Crafty-The-Fox/musec_pico_rp2040/PCB/pico/musec_pico.kicad_sch

## KiCad design PCB/pico/musec_pico.kicad_sch (2025-07-09)

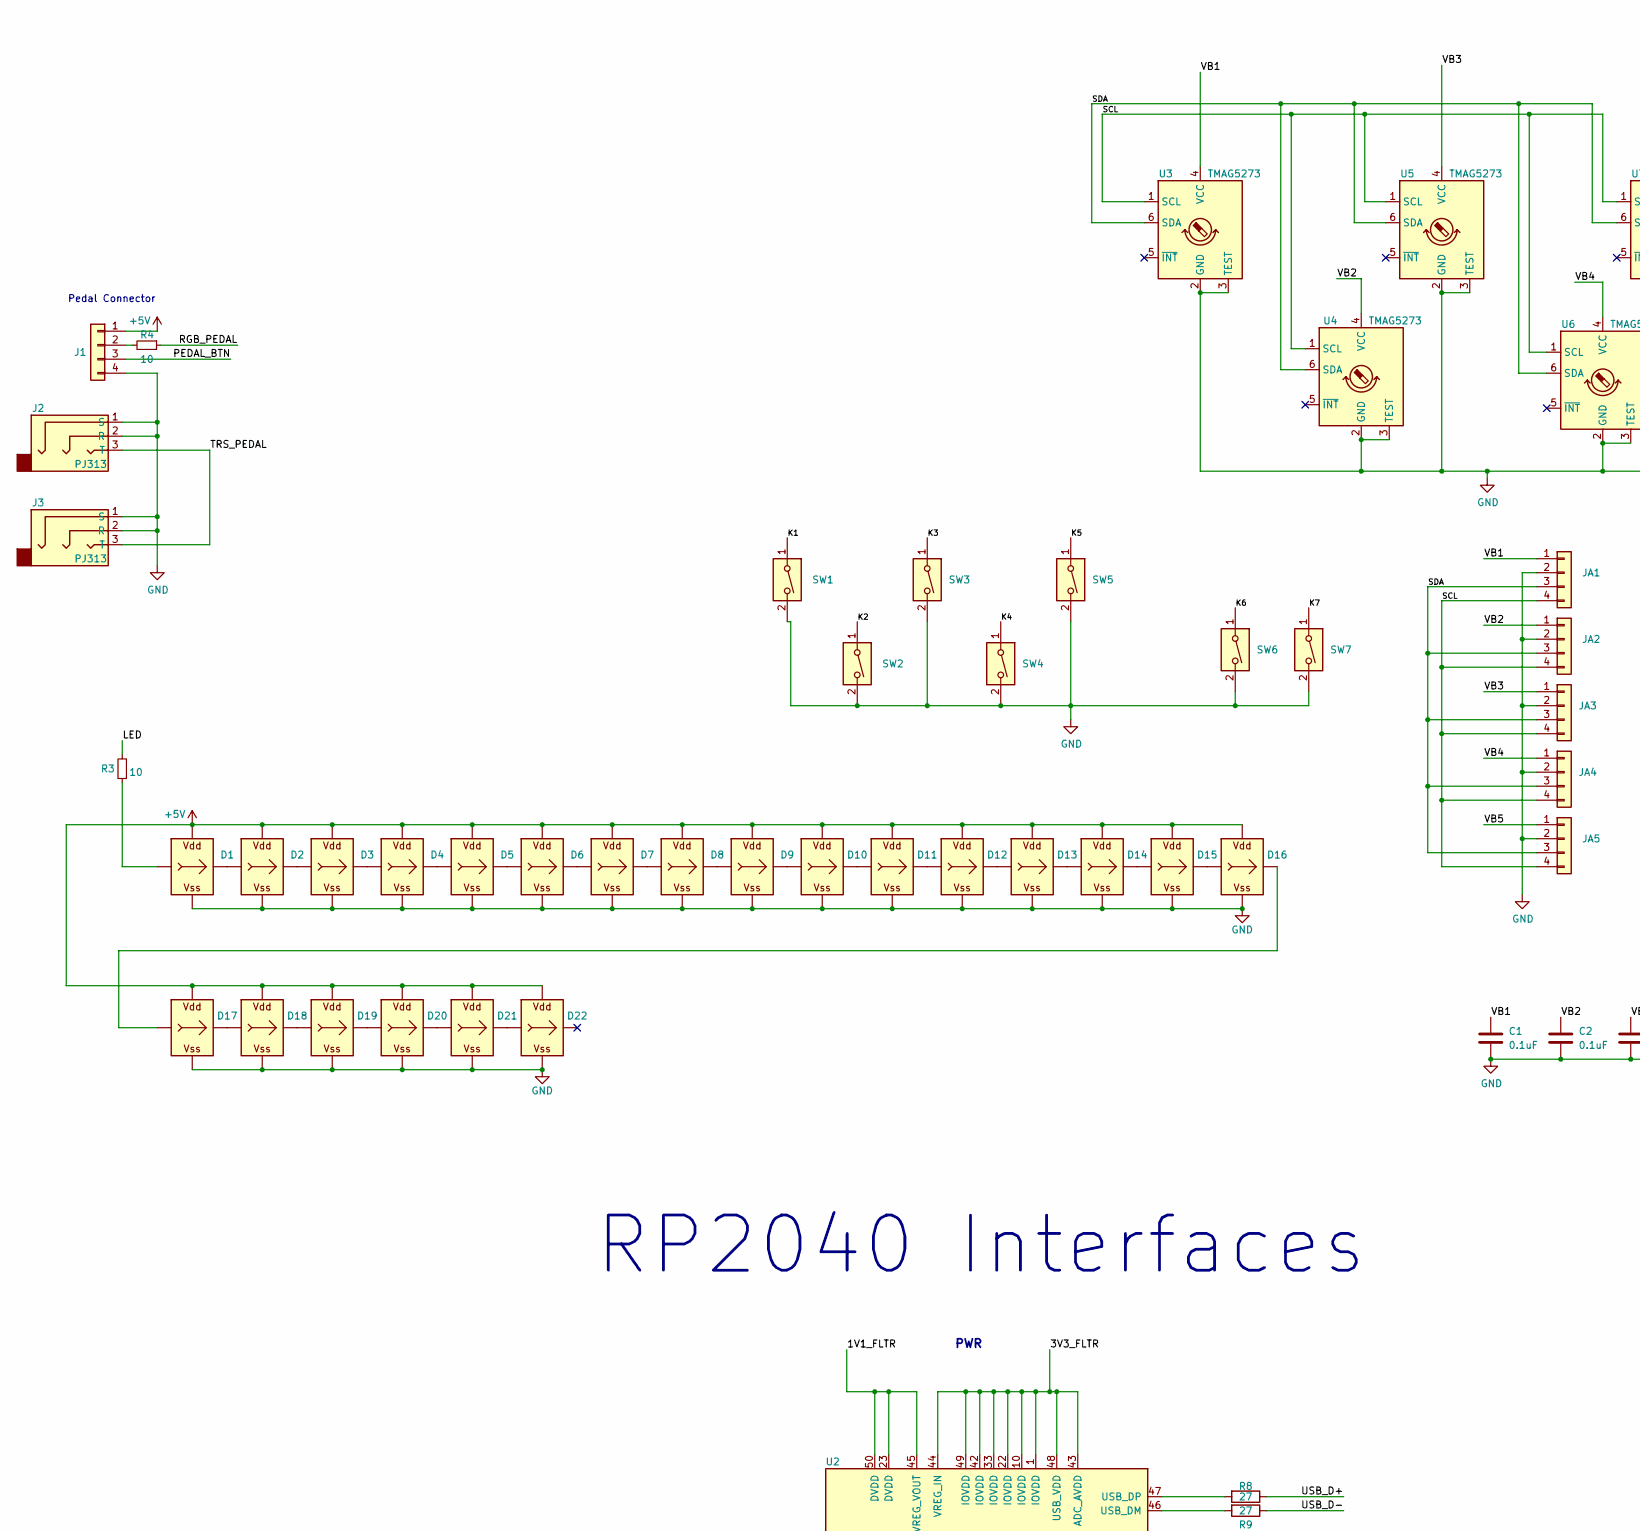
[picture p1: schematic musec_pico.kicad_sch, part in row 1, column 1]

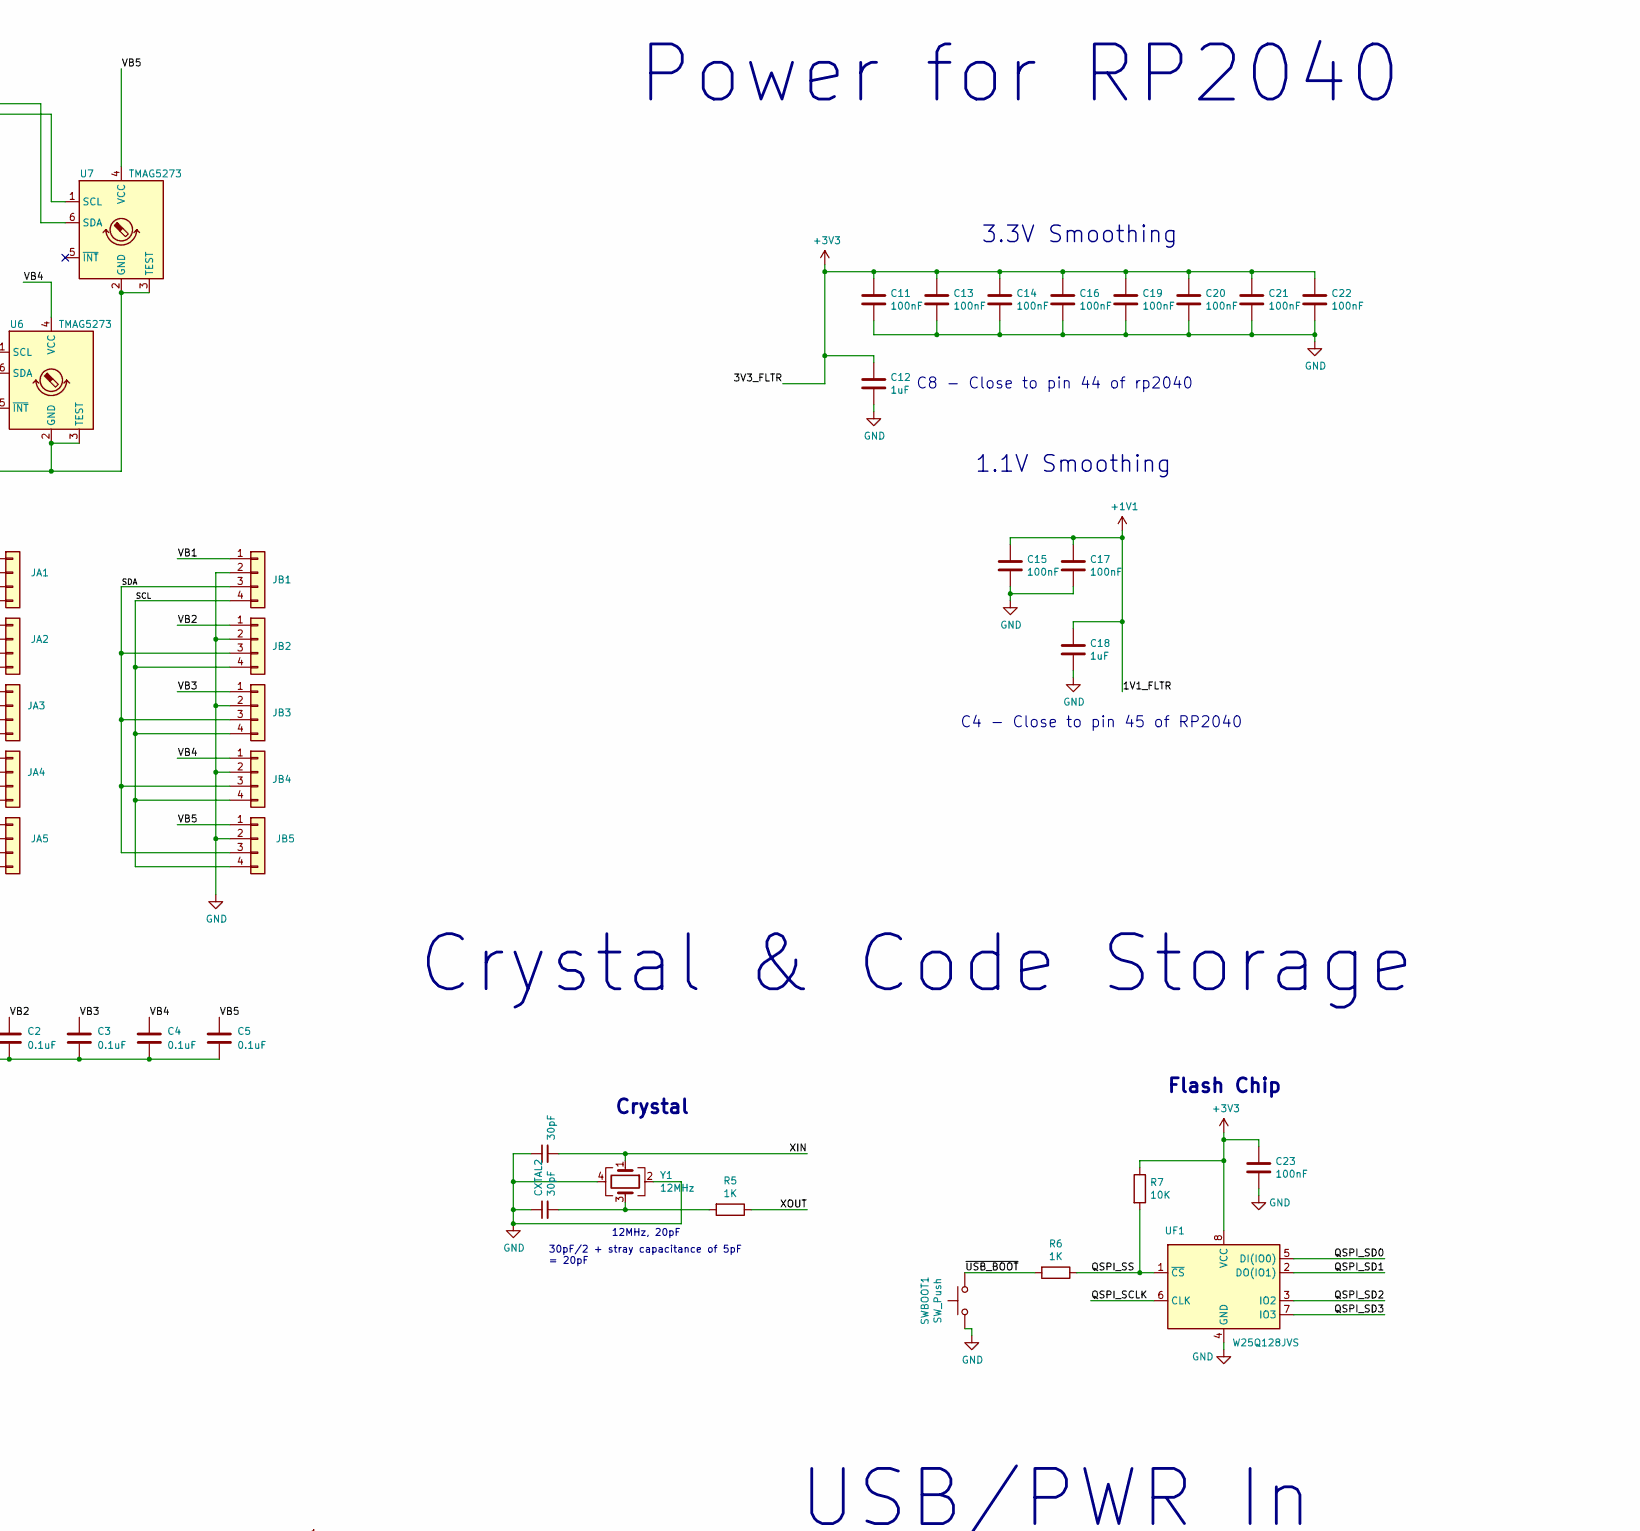
[picture p2: schematic musec_pico.kicad_sch, part in row 1, column 2]

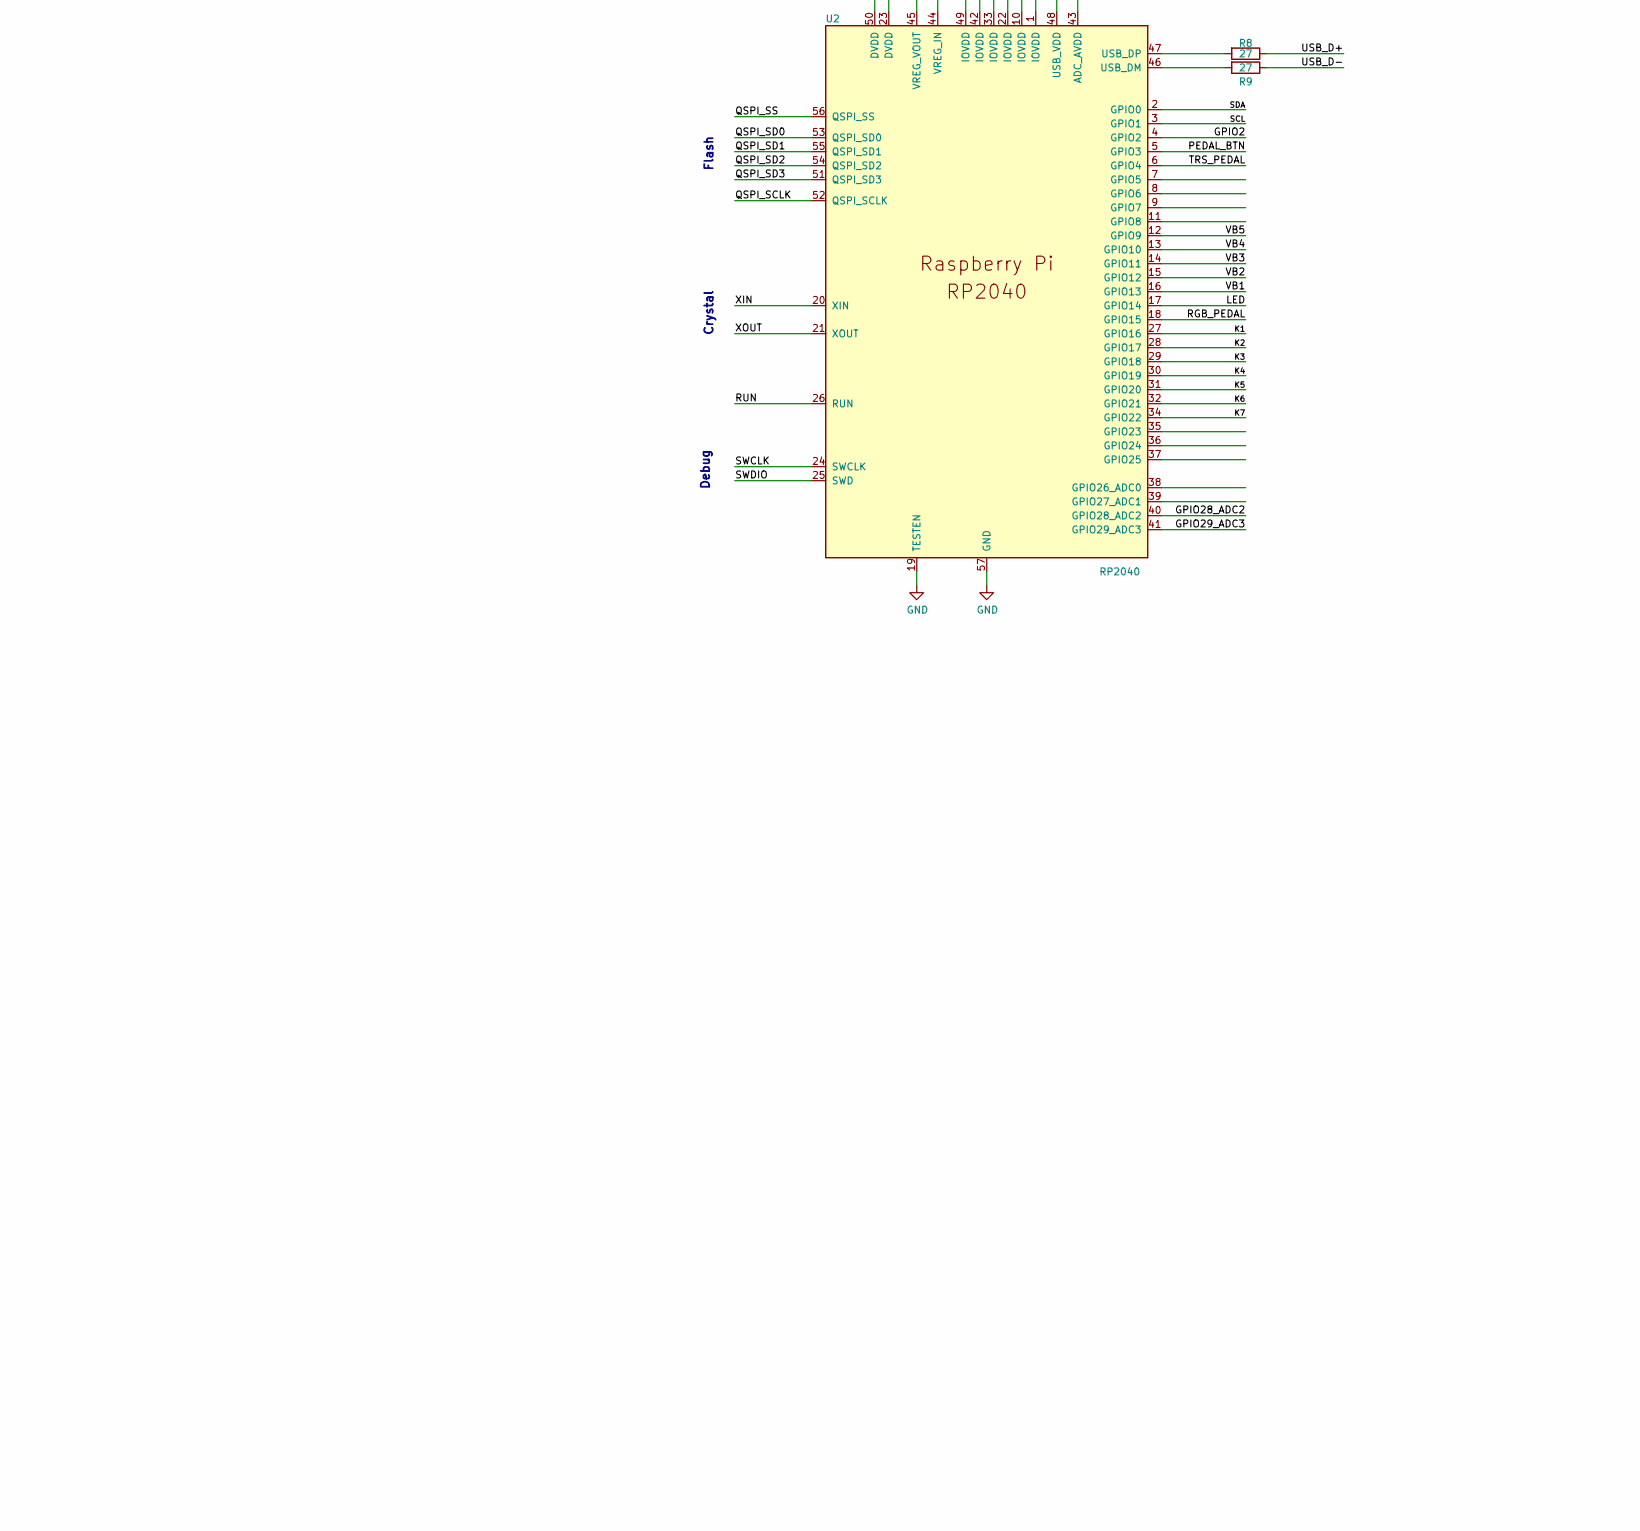
[picture p3: schematic musec_pico.kicad_sch, part in row 2, column 1]

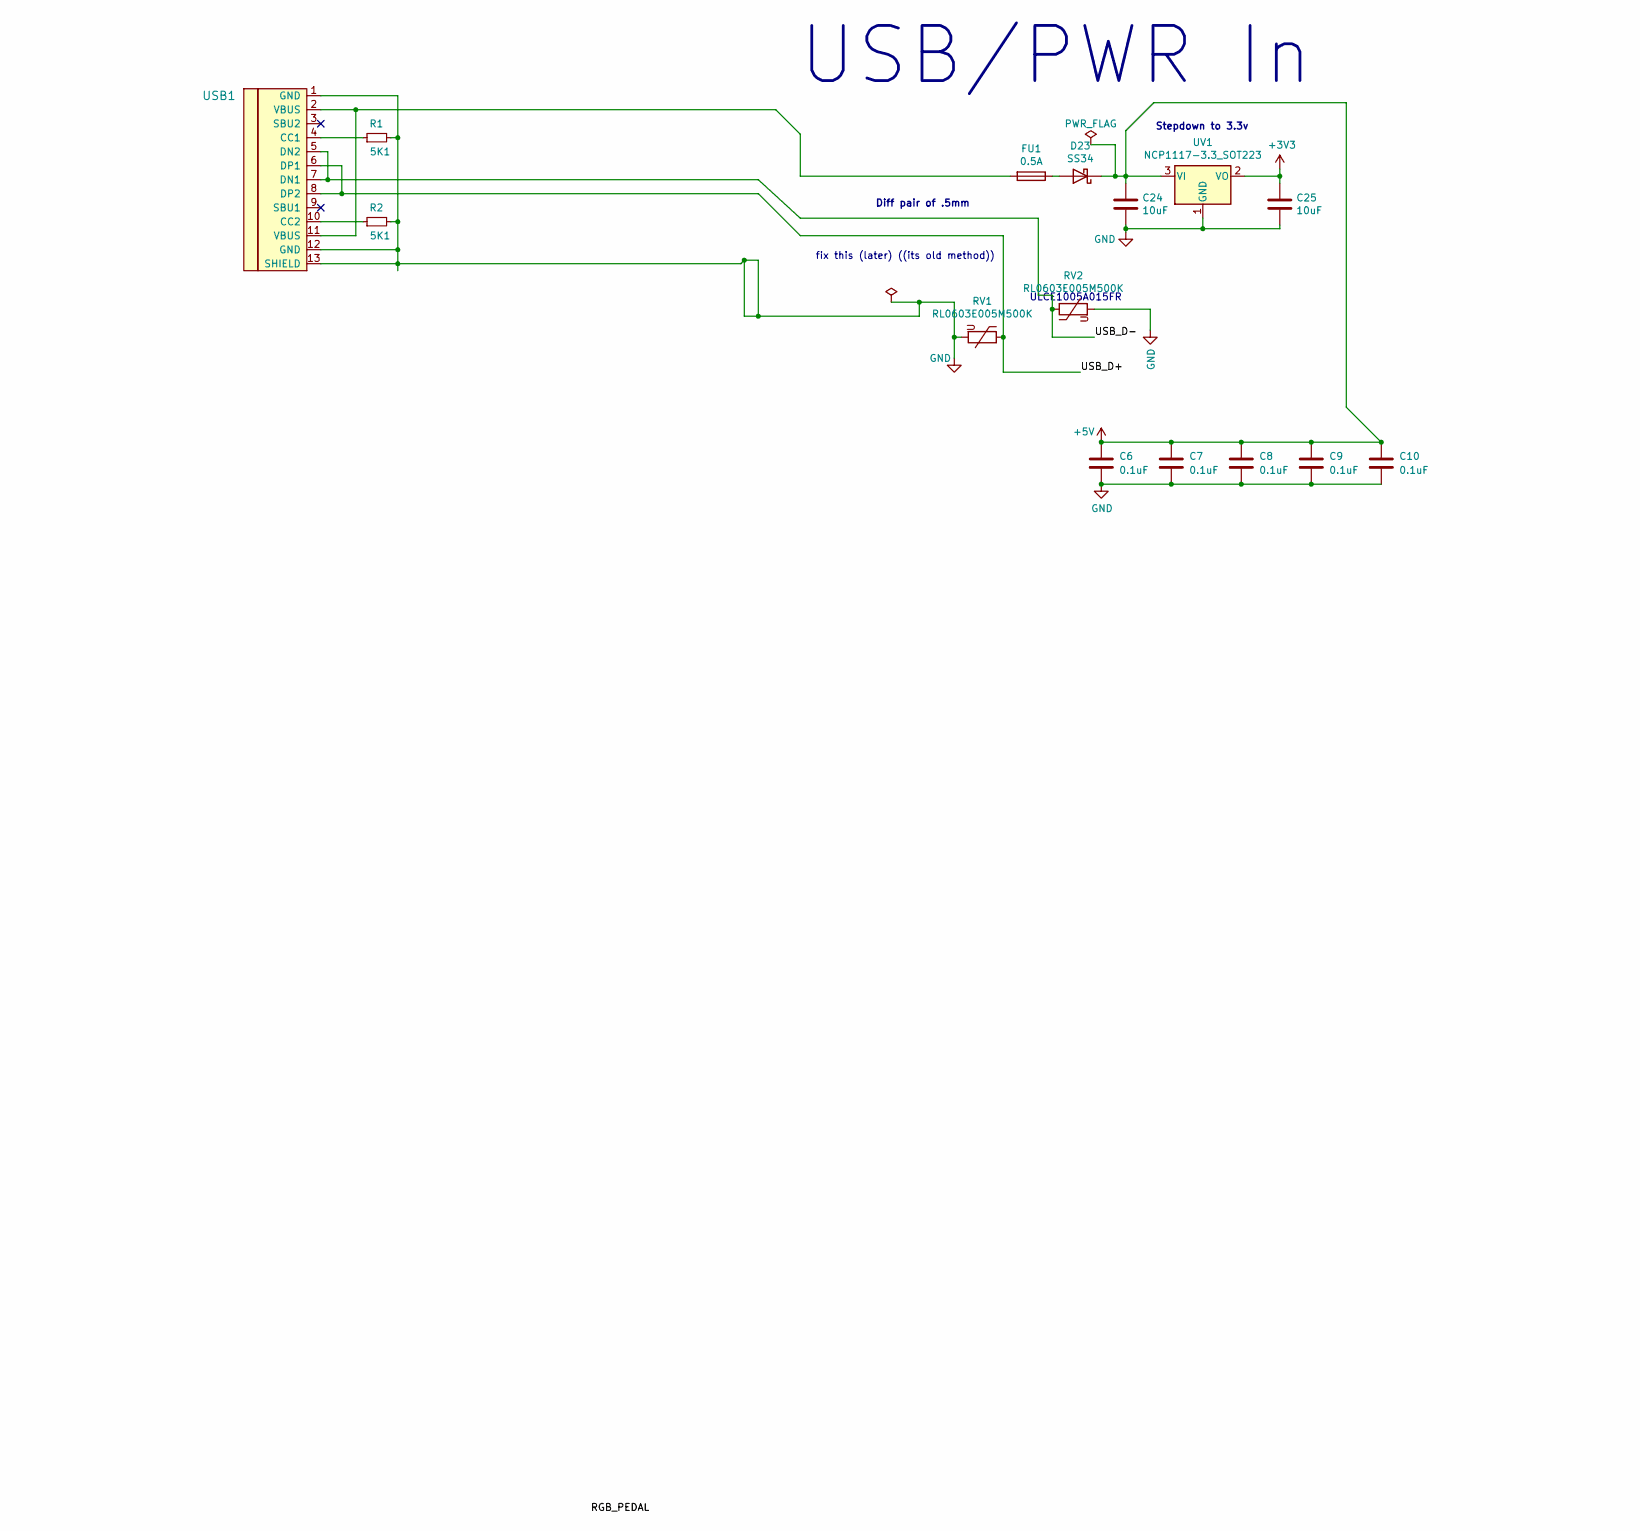
[picture p4: schematic musec_pico.kicad_sch, part in row 2, column 2]

Parts:
C1, C2, C3, C4, C5, C6, C7, C8, C9, C10: 0.1uF; C_0603_1608Metric_Pad1.08x0.95mm_HandSolder
C11, C13, C14, C15, C16, C17, C19, C20, C21, C22, C23: 100nF; C_0402_1005Metric; LCSC C1525
C12, C18: 1uF; C_0402_1005Metric; LCSC C52923
C24, C25: 10uF; C_0805_2012Metric; LCSC C15850
CXTAL1, CXTAL2: 30pF; C_0402_1005Metric; LCSC C1570
D1, D2, D3, D4, D5, D6, D7, D8, D9, D10, D11, D12, D13, D14, D15, D16, D17, D18, D19, D20, D21, D22: WS2812B_Unified; WS2812B-2835
D23: SS34; D_SMA; LCSC C8678
FU1: 0.5A; Fuse_1206_3216Metric_Pad1.42x1.75mm_HandSolder; LCSC C70068
J1: Pedal; SH1.0_4P_Solder_Combo
J2, J3: PJ313
JA1, JA2, JA3, JA4, JA5: Conn_01x04; SH1.0_4P_Solder_Combo
JB1, JB2, JB3, JB4, JB5: Conn_01x04; SH1.0_4P_Solder_Combo
R1, R2: 5K1; R_0603_1608Metric_Pad0.98x0.95mm_HandSolder; LCSC C23186
R3, R4: 10; R_0603_1608Metric_Pad0.98x0.95mm_HandSolder; LCSC C23186
R5: 1K; R_0402_1005Metric; LCSC C11702
R6: 1K; R_0603_1608Metric_Pad0.98x0.95mm_HandSolder; LCSC C21190
R7: 10K; R_0603_1608Metric_Pad0.98x0.95mm_HandSolder; LCSC C25804
R8, R9: 27; R_0603_1608Metric_Pad0.98x0.95mm_HandSolder; LCSC C25190
RV1, RV2: RL0603E005M500K; R_0603_1608Metric_Pad0.98x0.95mm_HandSolder; LCSC C20960
SW1, SW2, SW3, SW4, SW5, SW6, SW7: SW_DIP_x01; SW_Kailh_Choc_V1V2_1.00u_LED
SWBOOT1: SW_Push; SW_PUSH_6mm_H4.3mm
U2: RP2040; RP2040-QFN-56; LCSC C2040
U3, U4, U5, U6, U7: TMAG5273; TSOT-23-6_HandSoldering
UF1: W25Q128JVS; SOIC-8_5.275x5.275mm_P1.27mm; LCSC C97521
USB1: U262-161N-4BVC11; HRO-TYPE-C-31-M-12-Assembly; LCSC C319148
UV1: NCP1117-3.3_SOT223; SOT-223-3_TabPin2; LCSC C146799
Y1: 12MHz; Crystal_SMD_3225-4Pin_3.2x2.5mm; LCSC C9002

Connections:
+1V1: C15.1, C17.1, C18.1, U2.23 (DVDD), U2.45 (VREG_VOUT), U2.50 (DVDD)
+3V3: C11.1, C12.1, C13.1, C14.1, C16.1, C19.1, C20.1, C21.1, C22.1, C23.1, C25.1, R7.1, U2.1 (IOVDD), U2.10 (IOVDD), U2.22 (IOVDD), U2.33 (IOVDD), U2.42 (IOVDD), U2.43 (ADC_AVDD), U2.44 (VREG_IN), U2.48 (USB_VDD), U2.49 (IOVDD), UF1.8 (VCC), UV1.2 (VO)
+5V: C6.1, C7.1, C8.1, C9.1, C10.1, C24.1, D1.V (VDD), D2.V (VDD), D3.V (VDD), D4.V (VDD), D5.V (VDD), D6.V (VDD), D7.V (VDD), D8.V (VDD), D9.V (VDD), D10.V (VDD), D11.V (VDD), D12.V (VDD), D13.V (VDD), D14.V (VDD), D15.V (VDD), D16.V (VDD), D17.V (VDD), D18.V (VDD), D19.V (VDD), D20.V (VDD), D21.V (VDD), D22.V (VDD), D23.1 (K), J1.1, UV1.3 (VI)
GND: C1.2, C2.2, C3.2, C4.2, C5.2, C6.2, C7.2, C8.2, C9.2, C10.2, C11.2, C12.2, C13.2, C14.2, C15.2, C16.2, C17.2, C18.2, C19.2, C20.2, C21.2, C22.2, C23.2, C24.2, C25.2, CXTAL1.1, CXTAL2.1, D1.G (VSS), D2.G (VSS), D3.G (VSS), D4.G (VSS), D5.G (VSS), D6.G (VSS), D7.G (VSS), D8.G (VSS), D9.G (VSS), D10.G (VSS), D11.G (VSS), D12.G (VSS), D13.G (VSS), D14.G (VSS), D15.G (VSS), D16.G (VSS), D17.G (VSS), D18.G (VSS), D19.G (VSS), D20.G (VSS), D21.G (VSS), D22.G (VSS), J1.4, J2.1 (S), J2.2 (R), J3.1 (S), J3.2 (R), JA1.2, JA2.2, JA3.2, JA4.2, JA5.2, JB1.2, JB2.2, JB3.2, JB4.2, JB5.2, R1.2, R2.2, RV1.2, RV2.2, SW1.2, SW2.2, SW3.2, SW4.2, SW5.2, SW6.2, SW7.2, SWBOOT1.1, U2.19 (TESTEN), U2.57 (GND), U3.2 (GND), U3.3 (TEST), U4.2 (GND), U4.3 (TEST), U5.2 (GND), U5.3 (TEST), U6.2 (GND), U6.3 (TEST), U7.2 (GND), U7.3 (TEST), UF1.4 (GND), USB1.1 (GND), USB1.12 (GND), USB1.13 (SHIELD), UV1.1 (GND), Y1.2, Y1.4
GPIO2: U2.4 (GPIO2)
GPIO28_ADC2: U2.40 (GPIO28_ADC2)
GPIO29_ADC3: U2.41 (GPIO29_ADC3)
K1: SW1.1, U2.27 (GPIO16)
K2: SW2.1, U2.28 (GPIO17)
K3: SW3.1, U2.29 (GPIO18)
K4: SW4.1, U2.30 (GPIO19)
K5: SW5.1, U2.31 (GPIO20)
K6: SW6.1, U2.32 (GPIO21)
K7: SW7.1, U2.34 (GPIO22)
LED: R3.2, U2.17 (GPIO14)
unnamed: CXTAL2.2, R5.2, Y1.3
unnamed: D1.I (In), R3.1
unnamed: D1.O (Out), D2.I (In)
unnamed: D2.O (Out), D3.I (In)
unnamed: D3.O (Out), D4.I (In)
unnamed: D4.O (Out), D5.I (In)
unnamed: D5.O (Out), D6.I (In)
unnamed: D6.O (Out), D7.I (In)
unnamed: D7.O (Out), D8.I (In)
unnamed: D8.O (Out), D9.I (In)
unnamed: D9.O (Out), D10.I (In)
unnamed: D10.O (Out), D11.I (In)
unnamed: D11.O (Out), D12.I (In)
unnamed: D12.O (Out), D13.I (In)
unnamed: D13.O (Out), D14.I (In)
unnamed: D14.O (Out), D15.I (In)
unnamed: D15.O (Out), D16.I (In)
unnamed: D16.O (Out), D17.I (In)
unnamed: D17.O (Out), D18.I (In)
unnamed: D18.O (Out), D19.I (In)
unnamed: D19.O (Out), D20.I (In)
unnamed: D20.O (Out), D21.I (In)
unnamed: D21.O (Out), D22.I (In)
unnamed: D23.2 (A), FU1.1
unnamed: FU1.2, USB1.2 (VBUS), USB1.11 (VBUS)
unnamed: J1.2, R4.2
unnamed: R1.1, USB1.4 (CC1)
unnamed: R2.1, USB1.10 (CC2)
unnamed: R8.2, U2.47 (USB_DP)
unnamed: R9.2, U2.46 (USB_DM)
PEDAL_BTN: J1.3, U2.5 (GPIO3)
QSPI_SCLK: U2.52 (QSPI_SCLK), UF1.6 (CLK)
QSPI_SD0: U2.53 (QSPI_SD0), UF1.5 (DI(IO0))
QSPI_SD1: U2.55 (QSPI_SD1), UF1.2 (DO(IO1))
QSPI_SD2: U2.54 (QSPI_SD2), UF1.3 (IO2)
QSPI_SD3: U2.51 (QSPI_SD3), UF1.7 (IO3)
QSPI_SS: R6.1, R7.2, U2.56 (QSPI_SS), UF1.1 (~CS)
RGB_PEDAL: R4.1, U2.18 (GPIO15)
RUN: U2.26 (RUN)
SCL: JA1.4, JA2.4, JA3.4, JA4.4, JA5.4, JB1.4, JB2.4, JB3.4, JB4.4, JB5.4, U2.3 (GPIO1), U3.1 (SCL), U4.1 (SCL), U5.1 (SCL), U6.1 (SCL), U7.1 (SCL)
SDA: JA1.3, JA2.3, JA3.3, JA4.3, JA5.3, JB1.3, JB2.3, JB3.3, JB4.3, JB5.3, U2.2 (GPIO0), U3.6 (SDA), U4.6 (SDA), U5.6 (SDA), U6.6 (SDA), U7.6 (SDA)
SWCLK: U2.24 (SWCLK)
SWDIO: U2.25 (SWD)
TRS_PEDAL: J2.3 (T), J3.3 (T), U2.6 (GPIO4)
USB_D+: R8.1, RV1.1, USB1.6 (DP1), USB1.8 (DP2)
USB_D-: R9.1, RV2.1, USB1.5 (DN2), USB1.7 (DN1)
VB1: C1.1, JA1.1, JB1.1, U2.16 (GPIO13), U3.4 (VCC)
VB2: C2.1, JA2.1, JB2.1, U2.15 (GPIO12), U4.4 (VCC)
VB3: C3.1, JA3.1, JB3.1, U2.14 (GPIO11), U5.4 (VCC)
VB4: C4.1, JA4.1, JB4.1, U2.13 (GPIO10), U6.4 (VCC)
VB5: C5.1, JA5.1, JB5.1, U2.12 (GPIO9), U7.4 (VCC)
XIN: CXTAL1.2, U2.20 (XIN), Y1.1
XOUT: R5.1, U2.21 (XOUT)
~USB_BOOT: R6.2, SWBOOT1.2

Notes on the sheet:
USB/PWR In
Diff pair of .5mm
C8 - Close to pin 44 of rp2040
12MHz, 20pF
Debug
Crystal
Flash
RP2040 Interfaces
C4 - Close to pin 45 of RP2040
Stepdown to 3.3v
PWR
Power for RP2040
Pedal Connector
Flash Chip
1.1V Smoothing
Crystal & Code Storage
30pF/2 + stray capacitance of 5pF = 20pF
3.3V Smoothing
fix this (later) ((its old method))
ULCE1005A015FR
